OpenDrone-hw/OpenVTX/(commit log)

2026-08-05 Untrack agent instructions, clean README status wording
    CLAUDE.md is local-only by convention. It held the full hardware
    design reference, now relocated to hardware/DESIGN.md. README updated
    to reflect the actual repo state: no schematic or layout exists yet,
    so drop the aspirational schematic hierarchy and structure entries,
    drop (WIP) from the title, and add an accurate status line.
2026-08-05 Fix documentation fact-check findings in DESIGN.md
    - Correct 6dB pi-pad values: 150R shunts with 37.4R series (17.6R was
    the 3dB series arm, giving only 4.3dB attenuation)
    - Assign buck CIN to 4.7uF/50V X7R 1206 (C29823, basic part); C23733
    (10V) stays for general bulk on the 5V/3.3V rails only
    - Update consign list: STM32G431KBU6 and LMR51420YDDCR back in stock
    at LCSC/JLCPCB (2026-08-05), only RTC6705 remains consign
    - Replace expired OpenOSD-X Discord invite with current one
2026-09-01 Adopt shared KiCad datasheets
2026-09-19 docs: closing documentation package
    AGENTS.md 7 to 71 lines: drops the link to a workspace path absent from a public clone, records the verified repo state (kicad_pro, 14 symbols, 14 footprints, no schematic or board, DESIGN.md, tools/add_mpn_fields.py, reference/), Repo and Environment, the template Rules section stamped by agents_section_sync.py, and By task. Brief sections absent because no schematic exists; nothing invented.
    Claude-Session: https://claude.ai/code/session_012HzaDQJftK4deuM7TyZ3Cv
2026-09-24 docs: fix stale KiCad 9 reference in DESIGN.md (#10)
    hardware/DESIGN.md named KiCad 9 for the planned schematic structure while
    AGENTS.md's Repo table and the workspace-wide standard both say KiCad 10.
    No .kicad_sch exists yet in this repo to check a version header against, so
    this aligns the doc with AGENTS.md and the stated standard.
2026-10-12 docs(agents): cut AGENTS.md to validate, boundaries, pointers (#13)
    AGENTS.md 71 -> 18 lines. Removes architecture, tables, procedures and
    state; keeps only hard boundaries and the validation command.
    Claude-Session: https://claude.ai/code/session_017Ye54fa9v5VP179Xbw465R
2026-10-13 docs: restore AGENTS.md technical write-up (#14)
    Reverts the AGENTS.md cut and the README pointer change; the write-up is board documentation, not duplicated elsewhere.
    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
2026-11-11 docs(rules): kicad-skip cannot round-trip KiCad 10 schematics (#17)
    Syncs the shared Rules section from OpenDrone-hw/hardware-template (PR 16).
2026-11-14 README: mark the feature list as design intent, drop bold labels (#18)
    Before: 'Planned Features' (including ~500 mW output and protections) for a board with no schematic, bold-label bullets.
    After: 'Design intent' with a line stating none of it is in a schematic yet; 'Intended interface' heading; bold labels removed.
